digiampietro/esp8266-rs41/img/rs41-connector.png

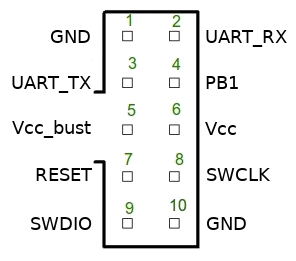
img/rs41-connector.png
