digiampietro/esp8266-rs41/(threads)

Thread 1 (2021-05-06):

D1 Mini only sets frequency after pressing reset button

zanco, 2021-05-06:
Hi,
I like the solution you found to be able to set the TX frequency of the RS41 direct after starting.

My problem is that the frequency is not changed after starting, blue led flashed rapidly, but, when still connected to the RS41, after pressing the reset on the D1 mini the frequency is changed.

However, after the reset the D1 cannot be find on my wifi network and aslo not in AP mode on my smartphone.

If I power off the RS41 the D1 also powers of, after turning power on at the RS41 the D1 powers on but fails to set frequency but does connect to my wifi so I can view it on my webbrowser, however as said, cannot change the frequency.

Any idea what I am missing over here ?

Thanks!

Thread 2 (2021-07-10):

Communication problem

fermars1974, 2021-07-10:
Hi,
Thank you for sharing this project; I am very excited to try it but there is something wrong and I cannot find the solution.
It seems that there is some kind of communication problem or if the communication is established, the commands sent to the RS41 are not good.  I can connect to the RS41 through USB-to-Serial interface and read/record frequencies manually so I assume RS41 and connections are good.
I opened a serial interface with PuTTY just to figure out what is going on, you can see this (I activated debug mode):

Read txfreq     from EEPROM: nan
Read time2sleep from EEPROM: 4294967295
Read ssid       from EEPROM: ▒▒▒▒▒▒▒▒▒▒▒▒▒▒▒▒▒▒▒▒▒▒▒▒▒▒▒▒▒
Read password   from EEPROM: ▒▒▒▒▒▒▒▒▒▒▒▒▒▒▒▒▒▒▒▒▒▒▒▒▒▒▒▒▒
Invalid time2sleep value, setting to 180
-----> calculateRegisters
frequency: nan
hbsel:     0
fb:        4294967295
fc:        4294967295
reg75      FFF
reg76      FFFFFF
reg77      FF
-----> Sending STwsv to enter command mode

-----> rs41_slow_write:
STwsv

.......entering rs41_get_serial

buftail:     0
buflastline: 0

Serial data from rs41:
------------------------------------------------------------------

------------------------------------------------------------------
======> Error in initializing the RS41 Registers

As you can see, the initial reading of the 75,76,77 are not correct (FF...), and also the Wemos D1 mini is unable to open the STwsv command so the Registers are not set.
I am not an expert in C++ or Arduino coding but I can see that it tries to establish the frequency writing just the letter "t" and when I do this via serial connection, I have to enter "t75" directly to get right response, like this:

>t75

t
Register number (00-7F) >75
Register value 16 >

If I just enter the "t" command and later the number "75" it gives me an error. Could this be the problem?

>t

t
Register number (00-7F) >
75

75
Failed!

I also modified the GETSERIALTIMEOUT and SLOWTIME_CMD to "2000" as you suggested in your comment but nothing.
I run out of ideas, any clue will be appreciated.

Thank you.
Fernando.

Thread 3 (2021-11-15):

Compiling errors

EA4SG, 2021-11-15:
Hello all:

After getting all necesary libreries I have some problems compiling your esp8266-rs41 program with Arduino IDE.

See enclosed errors while compiling.

Any help to solve these errors will be welcomed.

Thanks in advance de David

______________________________________________________________________________________________________________________________

Se encontraron varias bibliotecas para "ArduinoOTA.h"
In file included from C:\Users\David\Documents\Arduino\libraries\arduino-stdlib-master\Platform.h:8,
Usado: C:\Users\David\AppData\Local\Arduino15\packages\esp8266\hardware\esp8266\3.0.2\libraries\ArduinoOTA
                 from C:\Users\David\Documents\Arduino\libraries\arduino-stdlib-master\CDC.cpp:19:
 No usado: C:\Users\David\Documents\Arduino\libraries\ArduinoOTA
C:\Users\David\Documents\Arduino\libraries\arduino-stdlib-master/interrupt.h:347:75: error: extended character ↵ is not valid in an identifier
Se encontraron varias bibliotecas para "SoftwareSerial.h"
  347 |       <span aria-hidden="true" class="d-inline-block ml-1 v-align-middle">↵</span>
Usado: C:\Users\David\AppData\Local\Arduino15\packages\esp8266\hardware\esp8266\3.0.2\libraries\SoftwareSerial
      |                                                                           ^
 No usado: C:\Users\David\Documents\Arduino\libraries\EspSoftwareSerial
C:\Users\David\Documents\Arduino\libraries\arduino-stdlib-master/interrupt.h:352:56: error: extended character ↵ is not valid in an identifier
 No usado: C:\Users\David\Documents\Arduino\libraries\arduino-stdlib-master
  352 |       <span class="d-inline-block ml-1 v-align-middle">↵</span>
 No usado: C:\Users\David\Documents\Arduino\libraries\SoftwareSerial-master
      |                                                        ^
Se encontraron varias bibliotecas para "OTAdual.h"
In file included from C:\Users\David\Documents\Arduino\libraries\arduino-stdlib-master\Platform.h:8,
Usado: C:\Users\David\Documents\Arduino\libraries\arduino-stdlib-master
                 from C:\Users\David\Documents\Arduino\libraries\arduino-stdlib-master\CDC.cpp:19:
 No usado: C:\Users\David\Documents\Arduino\libraries\SoftwareSerial-master
C:\Users\David\Documents\Arduino\libraries\arduino-stdlib-master/interrupt.h:388:75: error: extended character ↵ is not valid in an identifier
  388 |       <span aria-hidden="true" class="d-inline-block ml-1 v-align-middle">↵</span>
      |                                                                           ^
C:\Users\David\Documents\Arduino\libraries\arduino-stdlib-master/interrupt.h:393:56: error: extended character ↵ is not valid in an identifier
  393 |       <span class="d-inline-block ml-1 v-align-middle">↵</span>
      |                                                        ^
In file included from C:\Users\David\Documents\Arduino\libraries\arduino-stdlib-master\Platform.h:8,
                 from C:\Users\David\Documents\Arduino\libraries\arduino-stdlib-master\CDC.cpp:19:
C:\Users\David\Documents\Arduino\libraries\arduino-stdlib-master/interrupt.h:420:75: error: extended character ↵ is not valid in an identifier
  420 |       <span aria-hidden="true" class="d-inline-block ml-1 v-align-middle">↵</span>
      |                                                                           ^
C:\Users\David\Documents\Arduino\libraries\arduino-stdlib-master/interrupt.h:425:56: error: extended character ↵ is not valid in an identifier
  425 |       <span class="d-inline-block ml-1 v-align-middle">↵</span>
      |                                                        ^
In file included from C:\Users\David\Documents\Arduino\libraries\arduino-stdlib-master\Platform.h:8,
                 from C:\Users\David\Documents\Arduino\libraries\arduino-stdlib-master\CDC.cpp:19:
C:\Users\David\Documents\Arduino\libraries\arduino-stdlib-master/interrupt.h:1243:9: error: extended character ’ is not valid in an identifier
 1243 |     You can’t perform that action at this time.
      |         ^
In file included from C:\Users\David\Documents\Arduino\libraries\arduino-stdlib-master/util/delay.h:39,
                 from C:\Users\David\Documents\Arduino\libraries\arduino-stdlib-master\Platform.h:9,
                 from C:\Users\David\Documents\Arduino\libraries\arduino-stdlib-master\CDC.cpp:19:
C:\Users\David\Documents\Arduino\libraries\arduino-stdlib-master/util/delay_basic.h:347:75: error: extended character ↵ is not valid in an identifier
  347 |       <span aria-hidden="true" class="d-inline-block ml-1 v-align-middle">↵</span>
      |                                                                           ^
C:\Users\David\Documents\Arduino\libraries\arduino-stdlib-master/util/delay_basic.h:352:56: error: extended character ↵ is not valid in an identifier
  352 |       <span class="d-inline-block ml-1 v-align-middle">↵</span>
      |                                                        ^
In file included from C:\Users\David\Documents\Arduino\libraries\arduino-stdlib-master/util/delay.h:39,
                 from C:\Users\David\Documents\Arduino\libraries\arduino-stdlib-master\Platform.h:9,
                 from C:\Users\David\Documents\Arduino\libraries\arduino-stdlib-master\CDC.cpp:19:
C:\Users\David\Documents\Arduino\libraries\arduino-stdlib-master/util/delay_basic.h:388:75: error: extended character ↵ is not valid in an identifier
  388 |       <span aria-hidden="true" class="d-inline-block ml-1 v-align-middle">↵</span>
      |                                                                           ^
C:\Users\David\Documents\Arduino\libraries\arduino-stdlib-master/util/delay_basic.h:393:56: error: extended character ↵ is not valid in an identifier
  393 |       <span class="d-inline-block ml-1 v-align-middle">↵</span>
      |                                                        ^
In file included from C:\Users\David\Documents\Arduino\libraries\arduino-stdlib-master/util/delay.h:39,
                 from C:\Users\David\Documents\Arduino\libraries\arduino-stdlib-master\Platform.h:9,
                 from C:\Users\David\Documents\Arduino\libraries\arduino-stdlib-master\CDC.cpp:19:
C:\Users\David\Documents\Arduino\libraries\arduino-stdlib-master/util/delay_basic.h:420:75: error: extended character ↵ is not valid in an identifier
  420 |       <span aria-hidden="true" class="d-inline-block ml-1 v-align-middle">↵</span>
      |                                                                           ^
C:\Users\David\Documents\Arduino\libraries\arduino-stdlib-master/util/delay_basic.h:425:56: error: extended character ↵ is not valid in an identifier
  425 |       <span class="d-inline-block ml-1 v-align-middle">↵</span>
      |                                                        ^
In file included from C:\Users\David\Documents\Arduino\libraries\arduino-stdlib-master/util/delay.h:39,
                 from C:\Users\David\Documents\Arduino\libraries\arduino-stdlib-master\Platform.h:9,
                 from C:\Users\David\Documents\Arduino\libraries\arduino-stdlib-master\CDC.cpp:19:
C:\Users\David\Documents\Arduino\libraries\arduino-stdlib-master/util/delay_basic.h:1420:9: error: extended character ’ is not valid in an identifier
 1420 |     You can’t perform that action at this time.
      |         ^
In file included from C:\Users\David\Documents\Arduino\libraries\arduino-stdlib-master\Arduino.h:9,
                 from C:\Users\David\Documents\Arduino\libraries\arduino-stdlib-master\Platform.h:15,
                 from C:\Users\David\Documents\Arduino\libraries\arduino-stdlib-master\CDC.cpp:19:
C:\Users\David\Documents\Arduino\libraries\arduino-stdlib-master/io.h:99:10: fatal error: avr/sfr_defs.h: No such file or directory
   99 | #include <avr/sfr_defs.h>
      |          ^~~~~~~~~~~~~~~~
compilation terminated.
exit status 1
Error compilando para la tarjeta LOLIN(WEMOS) D1 mini (clone).

Thread 5 (2023-06-06):

Not > OK computer?

nsouthon, 2023-06-06:
Following some collaberatiion on Facebook group Radiosonde UK, we found a workaround for an issue we had with the code not uploading the new frequencies - possibly on on later softare versions of RS41 sondes.

To enter service mode, the probe expects "STwsv", and then responds with the menu and the prompt ">"
Looking at the code (line 277), it seems to be expecting the reply "> OK"
Removing the 2 conditions in the 'if' statement and it worked (after a couple of reboots) and changes the frequency to 433.800.
if ((buf[buflastline+1] == '>') && (buf[3] == 'O') && (buf[4] == 'K')) {
to:
if ((buf[buflastline+1] == '>') ) {

This workaround was applies sucessfully on another install. I hope this is useful.

Oskimark, 2023-09-19:
i was having issues and just resolve to comment ALL the lines  referring to de RX part. so i was blindly throwing commands. but it worked.  Now i see the correct solution is that.

fermars1974, 2025-08-10:
Hi, I am unable to make it work on new RS41 2025. Original code works on RS41 from 2020.
I tried to change the line 277 as [nsouthon] suggest but for me it does not work, maybe some other things has changed...
[Oskimark], What lines did you comment?, I don't know exactly what the RX part is.
